Haskar/Star-Citizen-Controller/pictures/bd804097-d34a-4821-94e8-2e508bc554db.jpg

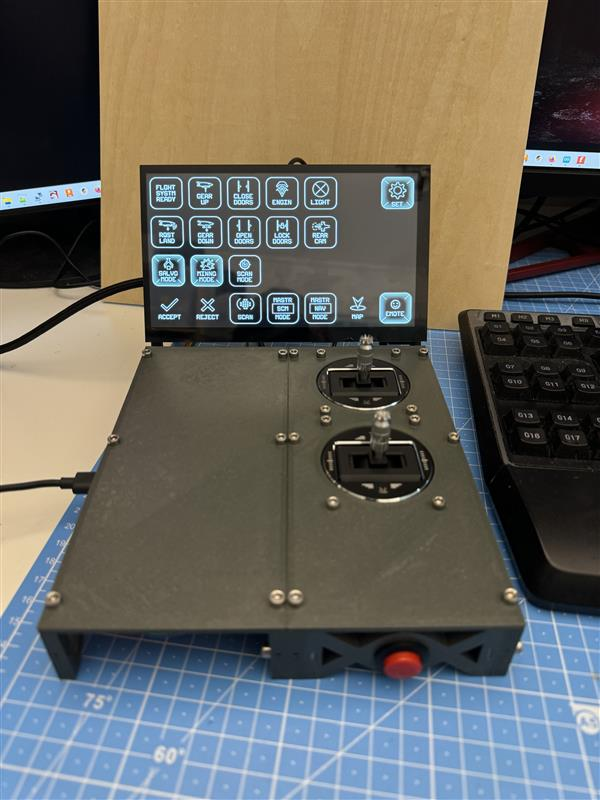
pictures/bd804097-d34a-4821-94e8-2e508bc554db.jpg
