Haskar/Star-Citizen-Controller/Raspberry Pi/controller/images/Aaron_Halo.png

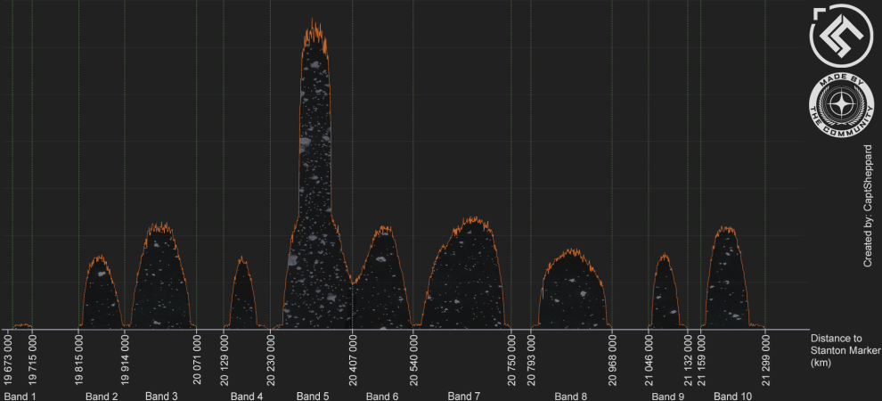
Raspberry Pi/controller/images/Aaron_Halo.png
