Haskar/Star-Citizen-Controller/Raspberry Pi/controller/images/general-ui-button-bright.png

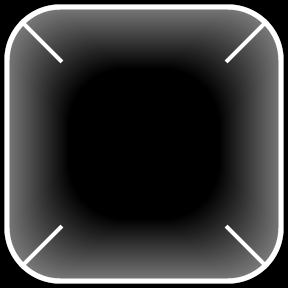
Raspberry Pi/controller/images/general-ui-button-bright.png
