Haskar/Star-Citizen-Controller/Raspberry Pi/controller/images/general-ui-button-dark.png

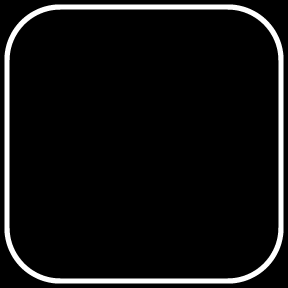
Raspberry Pi/controller/images/general-ui-button-dark.png
