Haskar/Star-Citizen-Controller/Raspberry Pi/controller/images/general-ui_button_shutdown.png

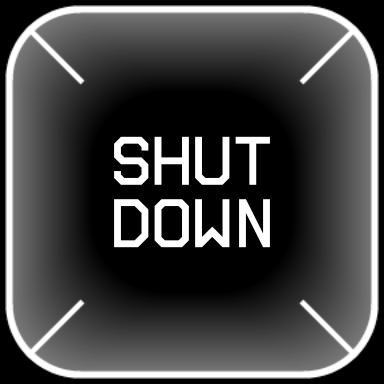
Raspberry Pi/controller/images/general-ui_button_shutdown.png
