Haskar/Star-Citizen-Controller/Raspberry Pi/controller/images/general-ui_button_update.png

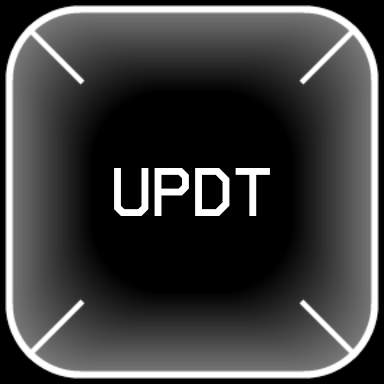
Raspberry Pi/controller/images/general-ui_button_update.png
