Haskar/Star-Citizen-Controller/Raspberry Pi/controller/images/vehicles_cockpit_lookbehind_ON.png

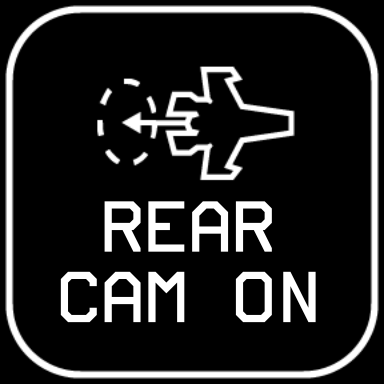
Raspberry Pi/controller/images/vehicles_cockpit_lookbehind_ON.png
